narad/knoblin/apidoc/knoblin.rst

knoblin package
===============

Submodules
----------

knoblin\.controller\_factory module
-----------------------------------

.. automodule:: knoblin.controller_factory
    :members:
    :undoc-members:
    :show-inheritance:

knoblin\.dial module
--------------------

.. automodule:: knoblin.dial
    :members:
    :undoc-members:
    :show-inheritance:

knoblin\.gui module
-------------------

.. automodule:: knoblin.gui
    :members:
    :undoc-members:
    :show-inheritance:

knoblin\.knob module
--------------------

.. automodule:: knoblin.knob
    :members:
    :undoc-members:
    :show-inheritance:

knoblin\.servo module
---------------------

.. automodule:: knoblin.servo
    :members:
    :undoc-members:
    :show-inheritance:

knoblin\.servo\_controller module
---------------------------------

.. automodule:: knoblin.servo_controller
    :members:
    :undoc-members:
    :show-inheritance:

knoblin\.sweep module
---------------------

.. automodule:: knoblin.sweep
    :members:
    :undoc-members:
    :show-inheritance:

knoblin\.test\_servo\_controller module
---------------------------------------

.. automodule:: knoblin.test_servo_controller
    :members:
    :undoc-members:
    :show-inheritance:

Module contents
---------------

.. automodule:: knoblin
    :members:
    :undoc-members:
    :show-inheritance:
