narad/knoblin/models/rails/lego_rails_v4.stl

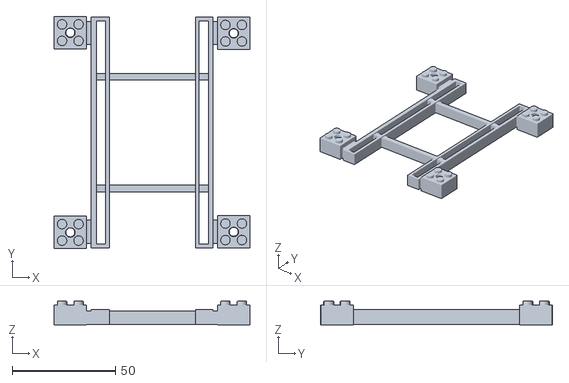
[picture p5: CAD file, 2021-11-01]
models/rails/lego_rails_v4.stl
95.0 x 112.6 x 11.4
