narad/knoblin/(commit log)

2021-11-01 interim commit before rename
    [lego_rails_v4.stl]
2021-11-08 added the arduino program
2021-11-11 fixed min and max servo controls which were wider than previously reported
    [dial.py, gui.py, knob.py, servo.py, servo_controller.py]
2021-11-14 added alignment points between knobs and servo, and a number of GUI and preset handling improvements using synchronous servo moving
2021-11-14 added comments to original servo controller ino file
2021-11-14 added synchronous servo controller for arduino
2021-11-15 fixed path changes to css
    [controller_factory.py, gui.py, servo.py]
2021-11-17 filtered requirements.txt to hopefully all the required packages
2024-08-18 edits to bring servo control back into generate_data.py
